Ombejeanne/Kubo/IMG_2198.JPG

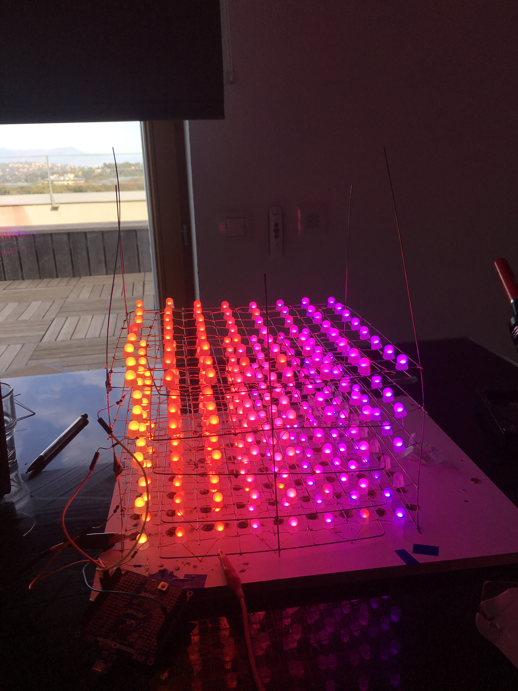
IMG_2198.JPG
