Ombejeanne/Kubo/README.md

# Kubo

# Matériel utilisé : 

-Leds rgb

-carte Arduino Uno

-Générateur

-tiges métalliques inoxydables

-module RTC ds1307

-module bluetooth hc-06

-carte à trous

-résistances

# A qui est destiné ce produit ?

Ce produit est utilisable par n'importe qui souhaitant décorer son lieu de vie.
