Ombejeanne/Kubo/Rapport Ombeline/Rapport de séance 7 Ombéline.odt

Rapport de séance 7 Ombéline :

Aujourd’hui, nous avons encore ressouder des LED qui étaient décollées sur les faces puis j’ai dessouder les faces du cube du groupe de l’année dernière pour qu’on récupère les LED. Pendant que Jeanne les testait, j’ai commencé à souder les LED qui fonctionnaient. A ce stade, nous pensons que nous allons faire 5 faces, donc le cube sera en fait un rectangle.

J’ai ensuite passé le reste de l’heure a essayé de faire fonctionner le programme final d’affichage de l’heure courante sur le cube mais je n’y arrive toujours pas. Je vais donc essayer chez moi de trouver un autre moyen d’afficher l’heure sans utiliser la fonction now() car peut être que le problème vient de là.
