Ombejeanne/Kubo/Rapport Ombeline/rapport de séance 6 Ombéline.odt

Rapport de séance 6 Ombéline :

J’ai programmé le module RTC tiny ds1307 i2c et j’ai installé la librairie RTClib. Ensuite, j’ai compris comment récupérer l’heure de l’ordinateur avec la librairie et comment la stocker dans le module. A partir de là, j’ai donc essayé de coder un programme qui afficherais les heures et les minutes à l’heure courante. Cependant, j’ai rencontré des difficultés. Tout d’abord, j’ai essayé d’afficher l’heure sur le moniteur série et d’ensuite exécuter la fonction « Nombre » pour afficher des nombres sur la face de LED, l’heure défile sur le moniteur série indéfiniment mais les LED ne s’affichent jamais.

Cependant, lorsque j’affiche seulement l’heure dans le moniteur série ça fonctionne et lorsque j’exécute la fonction « nombre » seule ça fonctionne.

J’ai aussi essayé d’exécuter la fonction « Nombre » en mettant en commentaire toutes les lignes de code concernant le module RTC et il semble que le problème vienne de la ligne suivante :

DateTime now = RTC.now() ;

Vous trouverez dans le dossier rapport Ombéline le programme « Heure_temps_reel »
