Ombejeanne/Kubo/Rapport Ombeline/Rapport séance 3 Ombéline.odt

Rapport séance 3 Ombéline :

Au début de la séance les LED du cube ne marchaient pas donc j’ai essayé avec Jeanne de comprendre d’où venait le problème en parcourant plusieurs causes possibles : problème de montage, de soudure, LED grillées… Ensuite, ne trouvant pas la cause de la panne, nous avons demandé de l’aide au prof.

Pendant ce temps et ce jusqu’à la fin de la séance, je me suis occupé de la programmation. D’abord j’ai fais un code qui permet d’allumer une LED sur deux et qui peut s’étendre à une LED sur le nombre que l’on veut.

Ensuite, j’ai repris le code « strandtest » de la librairie NeoPixel et j’ai essayé de comprendre le fonctionnement de toutes les fonctions proposées en les testant d’abord sur quelques LED puis la cinquantaine de LED présentes sur le début du cube.

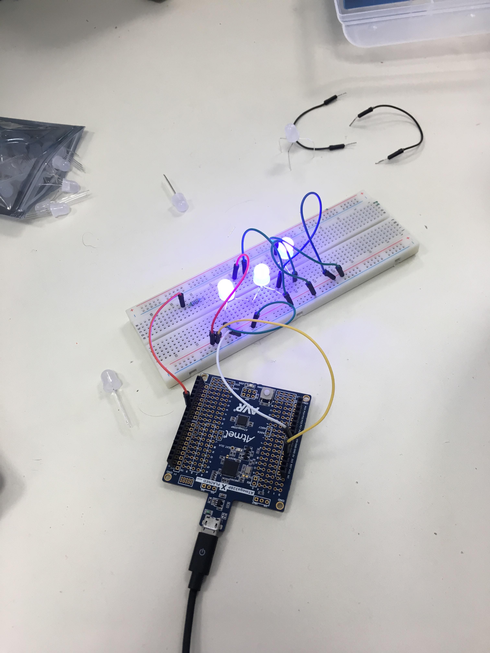
[picture p4: figure]
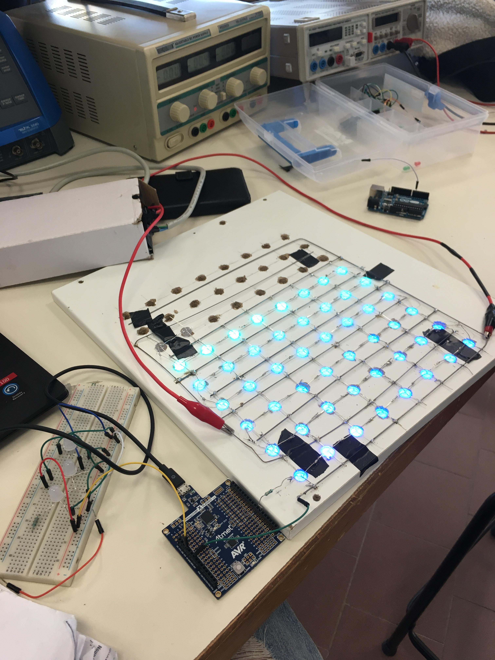
[picture p5: figure]
