Ombejeanne/Kubo/Rapport Ombeline/Rapport séance 1 Ombéline.docx

COMPTE-RENDU SEANCE 1 PROJET KUBO

Ombéline Carcouet

Pendant environ 1h nous avons hésité entre garder notre projet initial, c’est-à-dire le cube de LED, ou partir complètement sur une autre idée. En effet nous n’étions plus sûres car le binôme Théo-Thomas a un sujet similaire au nôtre Donc, pendant environ 1h Jeanne s’est renseigné davantage sur le cube de LED pendant que moi je réfléchissais à d’autres idées en faisant des recherches sur internet.

Finalement, nous avons décider de rester sur le cube de LED après avoir notamment regardé le site suivant : https://forum.arduino.cc/index.php?topic=203236.0.

Nous avons réfléchi aux options que nous souhaitons donner à notre cube et nous partons sur l’idée de faire un cube de 8x8 LED qui possèdera un mode veille, un mode qui réagit en fonction de la musique et un mode qui affiche l’heure en digital. Cependant, nous ne savons pas encore si tous seront réalisable.

Ensuite, Jeanne a réalisé le planning et moi je me suis chargé de rédiger le cahier des charges que vous trouverez sur notre Github.
