Ombejeanne/Kubo/Rapports Jeanne/Rapport séance 7 Jeanne Léauté.docx

Rapport séance 7 Jeanne Léauté

J’ai réalisé le programme qui permet de coder les nombres qui avancent et toutes les fonctions utiles à son fonctionnement. Il nous permettra d’afficher l’heure une fois que le problème actuel sera résolu. En effet, la fonction nombre et le module RTC ne fonctionnent pas ensemble sur un même fichier.

Pour réaliser cette fonction nombre j’ai abordé plusieurs stratégies mais la plus efficace et simple est celle du tableau à trois dimensions qui a permis de coder les 9 chiffres.

J’ai également réalisé une troisième face du cube. Il semble difficile d’envisager la possibilité de réaliser les 8 faces mais j’espère toujours avoir le temps. Le plus important pour l’instant est d’en réaliser au moins cinq afin de pouvoir utiliser le mode heure de notre projet.

Ci-joint le fichier heure_temps_reel qui ne fonctionne pas alors que les deux parties fonctionnent indépendamment l’une de l’autre.
