Ombejeanne/Kubo/Rapport Ombeline/rapport de séance 5 Ombéline.docx

Rapport de séance 5 Ombéline :

Aujourd’hui, j’ai réfléchi avec Jeanne à la manière de coder les 8 faces le plus simplement possible. J’ai pensé à réaliser des tableaux à plusieurs dimensions appelé « matrix », chaque tableau correspond à une face du cube. Un tableau à deux dimensions permet de donner la position de la LED que l’on veut allumer plus facilement en jouant sur les lignes et les colonnes. Cependant, le problème est qu’il faut instancier les tableaux avec 64 nombres dedans, ce qui serait très long. Finalement, nous allons plutôt essayer de simplifier le codage des faces avec des fonctions telles que la fonction « avance » qui permettra de faire défiler les chiffres que l’on codera ultérieurement.

En fin de séance, j’ai discuté avec M.Masson sur la manière de coder le tableau. Je vais donc y réfléchir avec le programme que M.Masson va m’envoyer.

La semaine prochaine, je vais coder les chiffres avec tableau ou fonction ou les deux.
